whowechina/groove_pico/README.md

# Groove Pico - Groove Coaster Style Mini Controller
[点这里可以切换到中文版](README_CN.md)

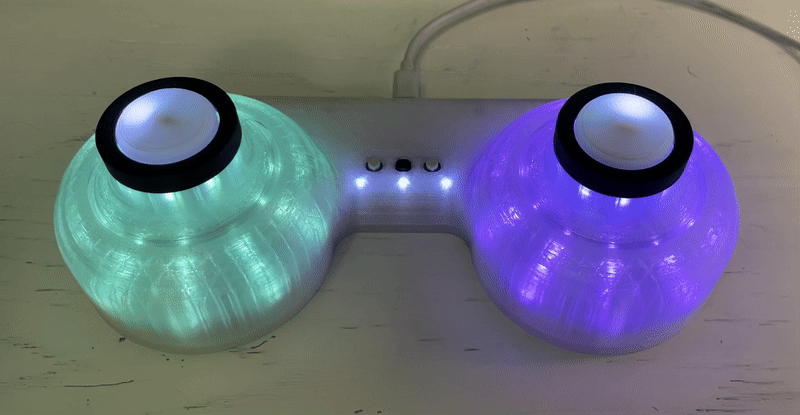
[picture p1: doc/main.gif]


Features:
* It's small but closely replicates the feel of the arcade controller.
* Works as a Nintendo Switch controller.
* Stereo haptic feedback.
* Command line for configurations.
* All source files open.

Thanks to many respectful guys/companies who made their tools or materials free or open source (KiCad, OnShape, InkScape, Raspberry things).

Special thanks to community developers that inspired me and helped me: CrazyRedMachine (https://github.com/CrazyRedMachine), asesidaa (https://github.com/asesidaa).

And also:
* RP_Silicon_KiCad: https://github.com/HeadBoffin/RP_Silicon_KiCad
* Type-C: https://github.com/ai03-2725/Type-C.pretty

## My Other Projects
You can check out my other cool projects.

             

* Popn Pico: https://github.com/whowechina/popn_pico
* IIDX Pico: https://github.com/whowechina/iidx_pico
* IIDX Teeny: https://github.com/whowechina/iidx_teeny
* Chu Pico: https://github.com/whowechina/chu_pico
* Mai Pico: https://github.com/whowechina/mai_pico
* Diva Pico: https://github.com/whowechina/diva_pico
* AIC Pico: https://github.com/whowechina/aic_pico
* Groove Pico: https://github.com/whowechina/groove_pico
* Geki Pico: https://github.com/whowechina/geki_pico
* Musec Pico: https://github.com/whowechina/musec_pico
* Ju Pico: https://github.com/whowechina/ju_pico
* Bishi Pico: https://github.com/whowechina/bishi_pico
* Bishi Pico: https://github.com/whowechina/nos_pico

## **Disclaimer** ##
I made this project in my personal time with no financial benefit or sponsorship. I will continue to improve the project. I have done my best to ensure that everything is accurate and functional, there's always a chance that mistakes may occur. I cannot be held responsible for any loss of your time or money that may result from using this open source project. Thank you for your understanding.

## About the License
It's CC-NC. So DIY for yourself and for your friend, don't make money from it. And plagiarism that doesn’t even dare to mention the original author is not acceptable. Plase note that pooling orders and group buying for raw materials is acceptable. Selling off any leftover components without profit is also acceptable.

If you're interested in buying from me, or for commercial use, please contact me (Discord, QQ group, Wechat group or leave your contact in issue section).

## My Discord Invitation
https://discord.gg/M8f2PPQFEA

## HOW TO BUILD
### PCB
* Go JLCPCB and make order with the gerber zip file (latest `Production\PCB\groove_main_xxx.zip`), regular FR-4 board, black or white color, **1.6mm** thickness.  
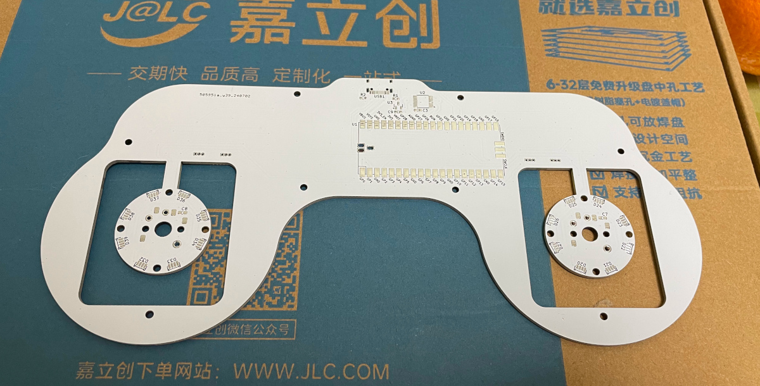
[picture p2: doc/pcb.jpg]
  
* 1x Rasberry Pico Pi Pico or pin-to-pin compatible clones (U1).  
  https://www.raspberrypi.com/products/raspberry-pi-pico
* 1x USB Type-C socket (918-418K2023S40001 or KH-TYPE-C-16P)
* 24x WS2812B-4020 side-facing RGB LEDs for the circular gimbal daughter PCBs (D20-D43).  
  https://www.lcsc.com/product-detail/Light-Emitting-Diodes-LED_Worldsemi-WS2812B-4020_C965557.html
* 19x WS2812B-3528 RGB LEDs for the main PCB (D1-D19).
* 1x 74HC4052PW, TSSOP16 package (U2).  
  https://www.lcsc.com/product-detail/Multiplexer-Demultiplexer_Nexperia-74HC4052PW_50063.html
* 2x 2N7002 SOT-23 N-Channel MOSFETs (Q1, Q2). Actually most SOT-23 package N-Channel MOSFET models will be fine.  
  https://www.nexperia.com/products/mosfets/small-signal-mosfets/2N7002.html
* 4x SH 1.25mm 3-pin connectors, both through-hole and SMD types are acceptable.  
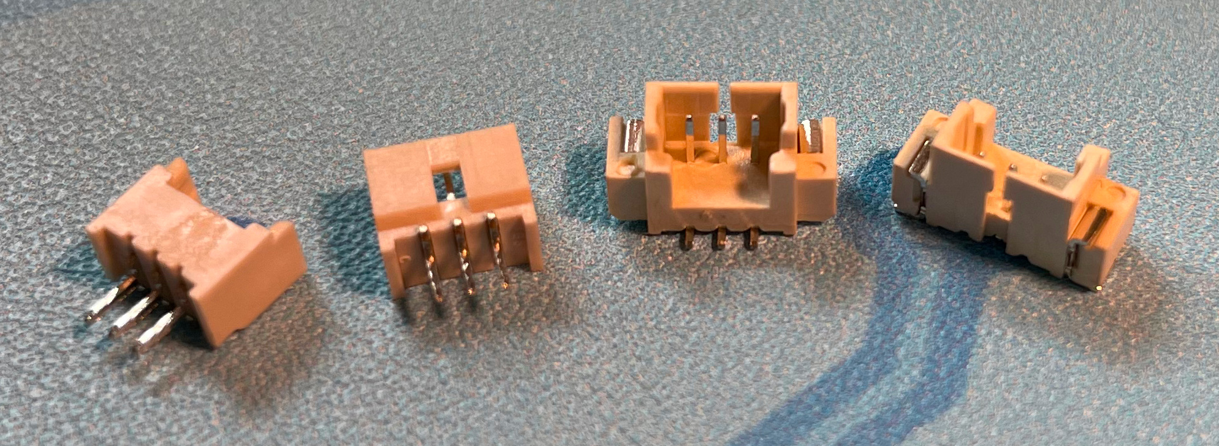
[picture p3: doc/sh125_3p.jpg]
  
* 9x 0603 0.1uF (0.1~1uF all fine) capacitors (C1 to C9), OPTIONAL but recommended.
* 2x 0603 5.1kohm resistors (R1, R2) for the USB.
* 5x 0603 10ohm resistors, (1-20ohm all work fine) (R3-R7).
* 1x LM4040A30IDBZ 3.0V shunt voltage reference (U3, SOT23-3), OPTIONAL but recommended. Model can be different, as long as it's a SOT23-3 3.0V shunt voltage reference.
* 1x 0603 100ohm resistor (R5), mandatory when U3 is present.
* 2x Kailh choc v1 switches, use light linear ones (around 35gf), such as "Red Pro".  
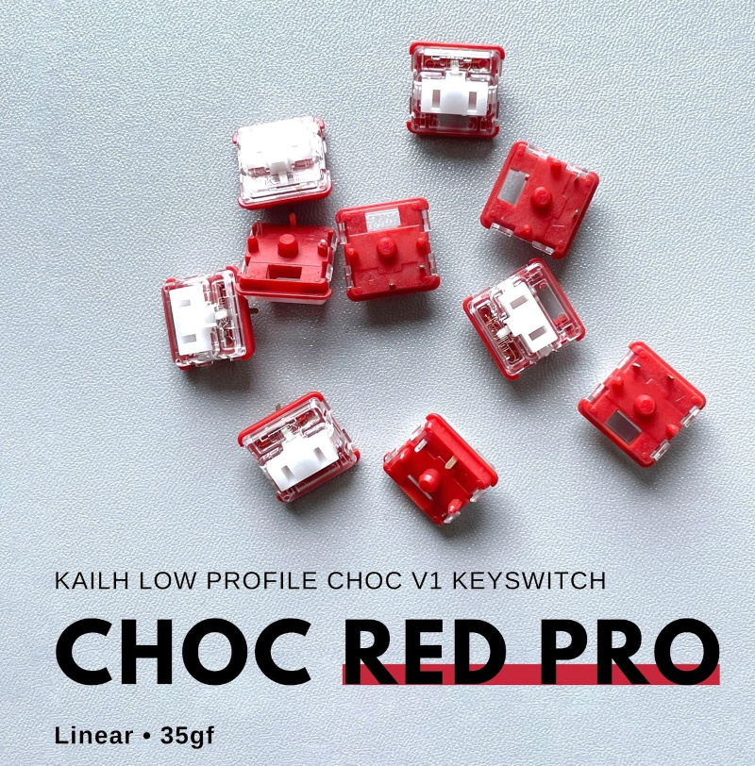
[picture p4: doc/choc_v1_red_pro.jpg]
  
* 3x ALPS SKPMAME010 or Panasonic EVQP1K05M 6mm square tactile switches, You can use either one exclusively or a combination of both.  
  https://tech.alpsalpine.com/e/products/detail/SKPMAME010/  
  https://www3.panasonic.biz/ac/e/dl/catalog/index.jsp?series_cd=3473&part_no=EVQP1K05M
* 2x BETAFPV nano gimbals (Potentiometer, Pitch/Roll Stick). You can buy them from online RC or FPV shops. Some call "Pitch/Roll stick" as directional stick which provides auto-center for both axes.  
  https://betafpv.com/products/literadio-transmitter-nano-gimbal-for-literadio-3-and-2-se?variant=39628763529350
* 2x 1027 or 1030 DC 3V flat vibration motors.  
  https://www.amazon.com/vibration-electronic-equipment-12000RPM-adhesive/dp/B08B34W24X
* 2x M3 hex nuts.
* This is how it looks after soldering. Please note that the two circular daughter PCBs are fully wired, so you can test them before cutting them off.  
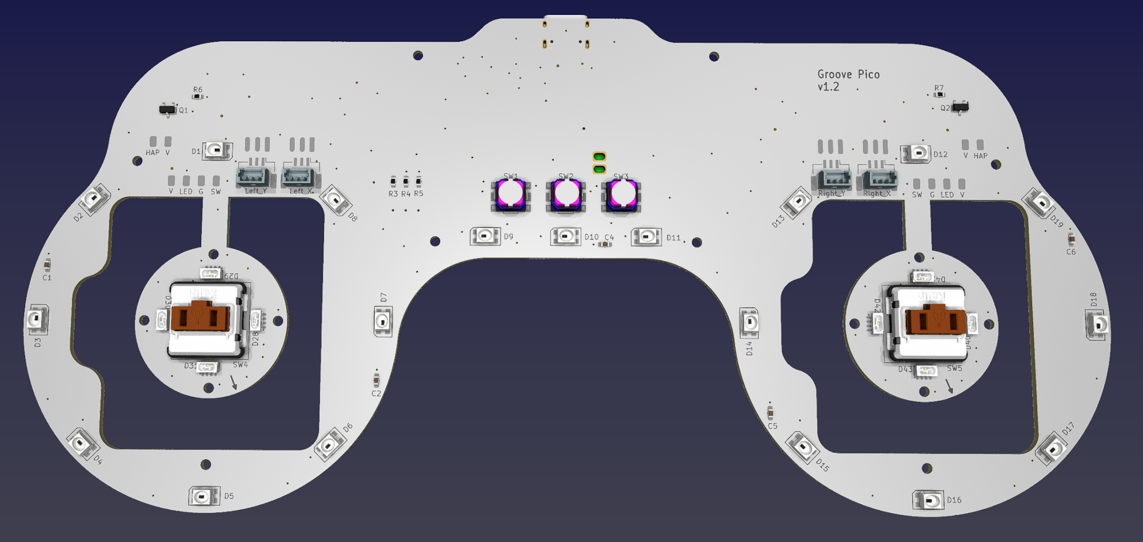
[picture p5: doc/pcb_solder_1.png]
    
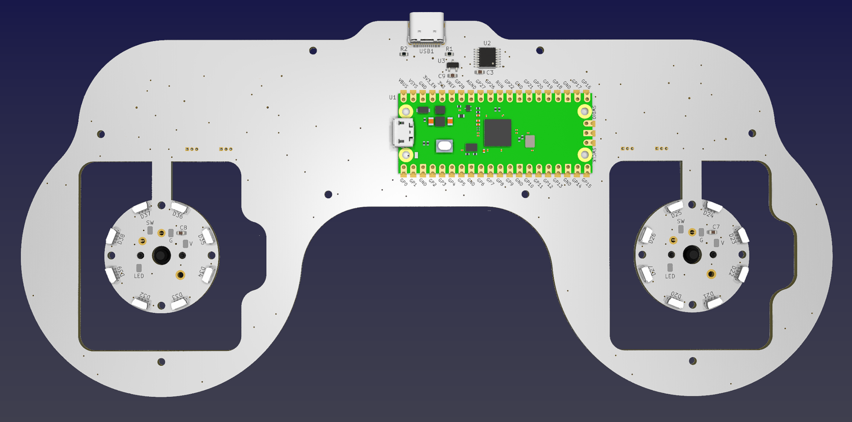
[picture p6: doc/pcb_solder_2.png]
  
* Becareful of 3 pin holes (simplifed to 2 holes in latest version) on the top side. It's a common oversight to either forget to solder them or to leave air bubbles during the process. To avoid this, solder slowly from one side of the hole, using minimal solder wire and a generous amount of flux.  
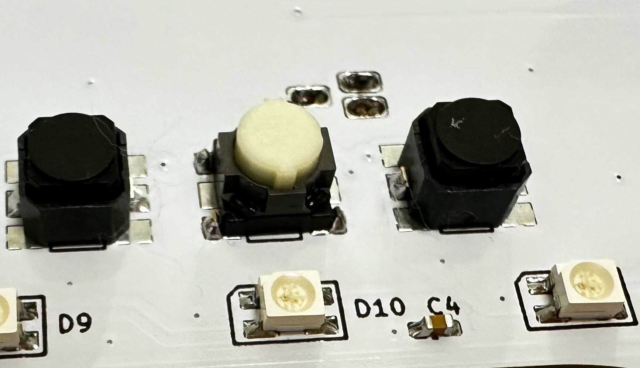
[picture p7: doc/usb_solder_txrx.jpg]
  
* After it passes the test, you need to cut the circular daughter PCBs off.  
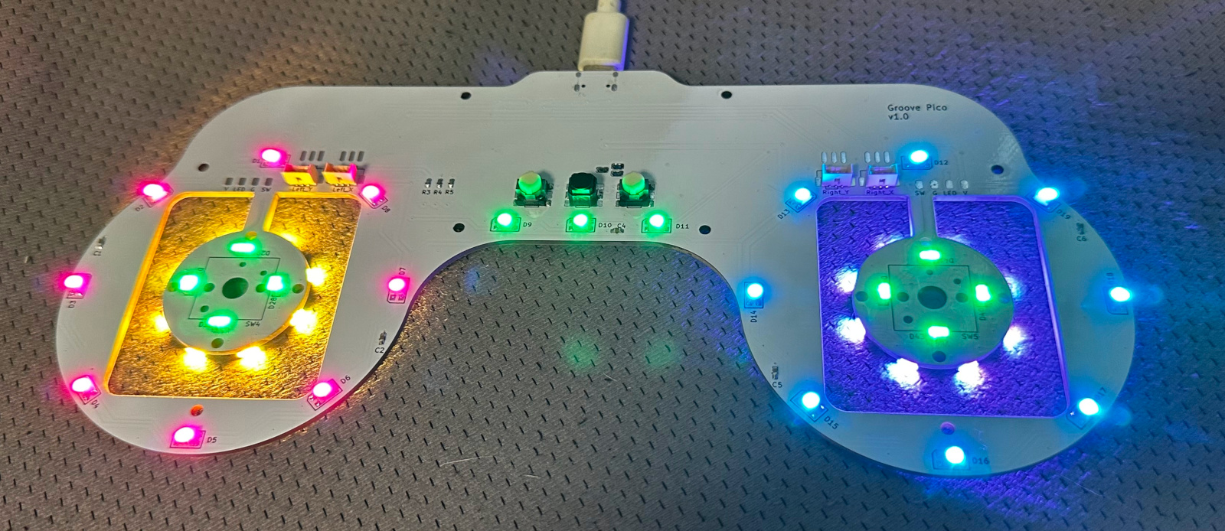
[picture p8: doc/pcb_test.jpg]
  
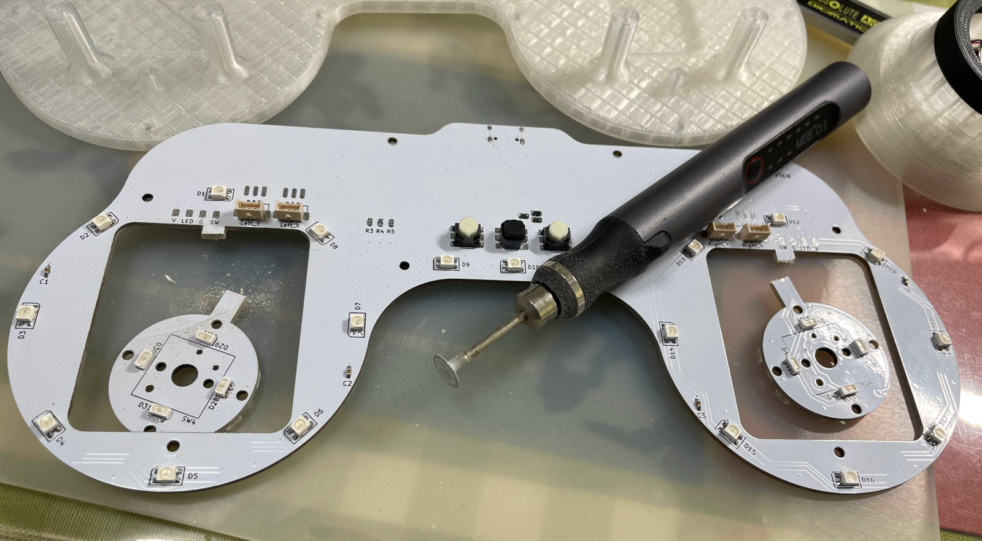
[picture p9: doc/pcb_cut_1.jpg]
  
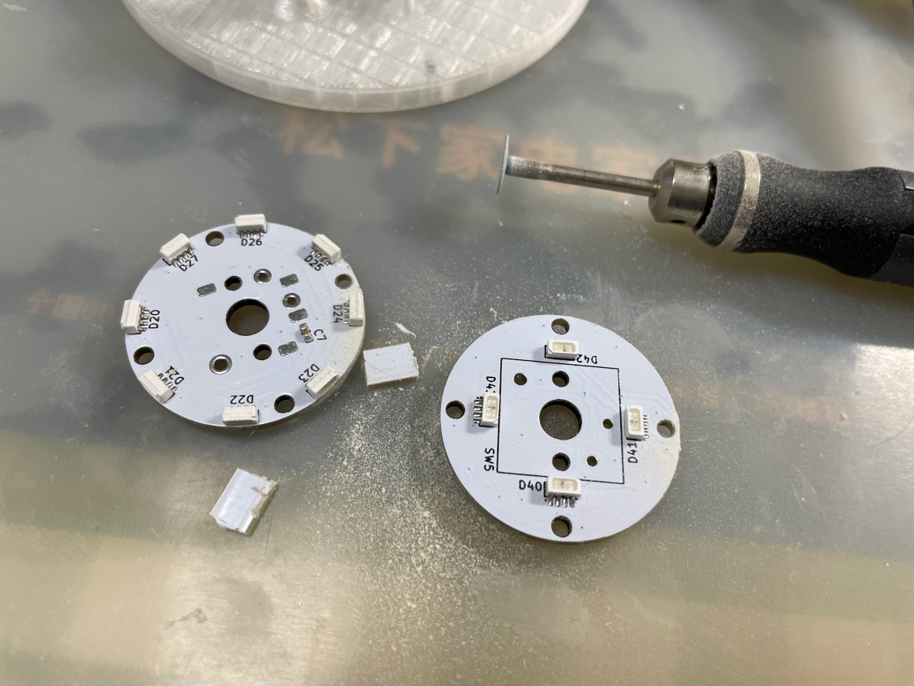
[picture p10: doc/pcb_cut_2.jpg]
  

### 3D Printing
* Printing parameters  
  * PLA, PETG, ABS are all OK.
  * Layer height: 0.2mm
  * Support: Yes, always.

* Bottom Part: `Production\3DPrint\groove_pico_bottom.stl`, semi-transparent filament.
* Top Part: `Production\3DPrint\groove_pico_top.stl`, semi-transparent filament.
* Gimbal Stick: `Production\3DPrint\groove_pico_stick.stl`, semi-transparent filament. If you have Bambu AMS system, print the upper (above 22mm) layers with black filament.
* Gimbal Bolt: `Production\3DPrint\groove_pico_bolt.stl`, white filament.
* Gimbal Tightener: `Production\3DPrint\groove_pico_tightener.stl`, white filament.
* Button cap: `Production\3DPrint\groove_pico_button_cap.stl`, white filament, print up-side down so you get nice button surface and stem. If you have Bambu AMS system, use their special support material for the interface layer.

### Nano Gimbal Modification (Optional)
* The BETAFPV Nano Gimbals are designed for RC transmitters, the original equipped springs are a little too light for Groove Pico. If you don't like the loose feel, you can change the springs by yourself.
* I measured the original springs, they're **0.3\*3\*10mm** (means 0.3mm steel wire diameter, 3mm outter diameter, 10mm free length, the first pair from the left). So if you want a heavier feel, you can use **0.35\*3\*10mm** (the second pair from the left), **0.4\*3\*10mm** (the third pair from the left), or even **0.3\*3\*8mm** (the last pair) tension springs.  
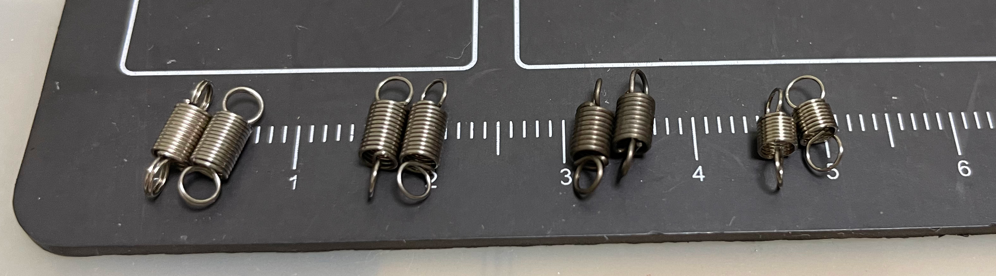
[picture p11: doc/gimbal_springs.jpg]
  
* You need to unscrew all screws to replace both X and Y axis springs. The job looks difficult but after you do it once, you'll find it's not that hard.
* You may feel the gimbal a little too bouncy, especially the X axis. You can apply some damping grease to the sliding surface to reduce the bounce (put more on X-axis sliding surface). I found Type-T03 is a good choice.  
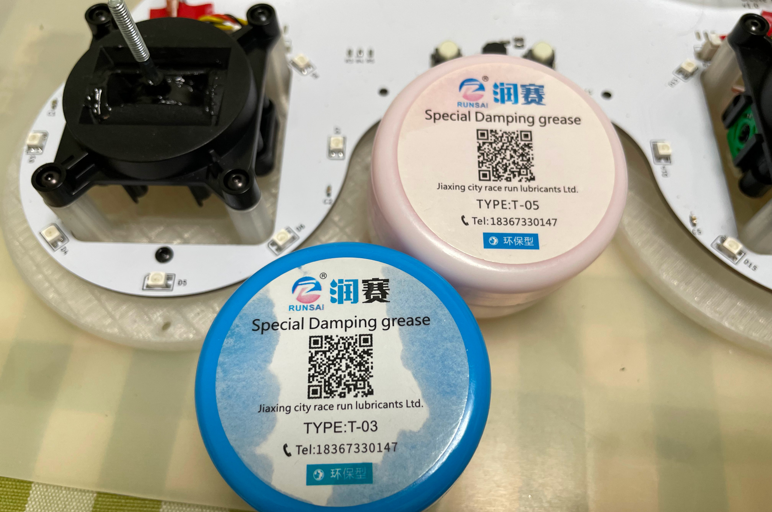
[picture p12: doc/damper_grease_1.jpg]
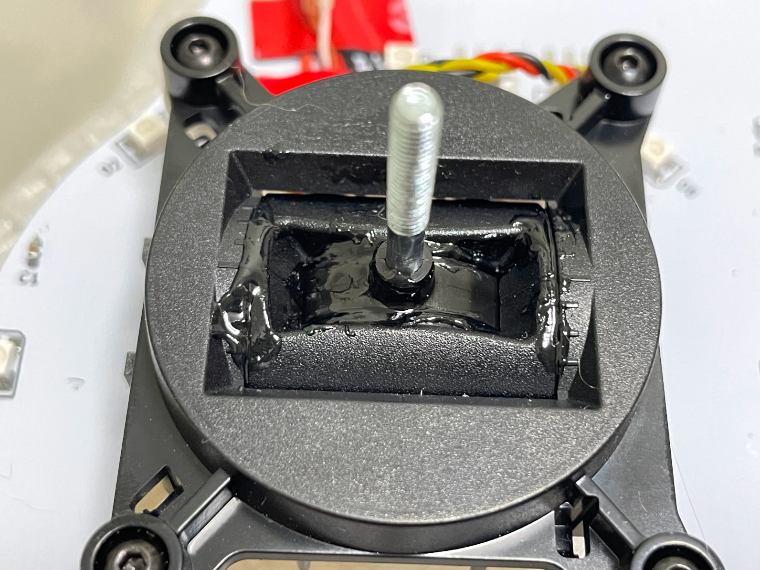
[picture p13: doc/damper_grease_2.jpg]
   

### Assembly
* Other components needed
  * 20x **M2\*4mm regular screws** to fix main PCB and daughter PCBs.
  * 20x **M2.5\*8mm regular screws** to fix the Nano Gimbals and hold bottom and top parts together.
  * 7x **10\*2** or **10\*3** (10mm diameter, 2mm or 3mm height) **self-adhesive silicone anti-slip pads** to stick to the bottom part.  
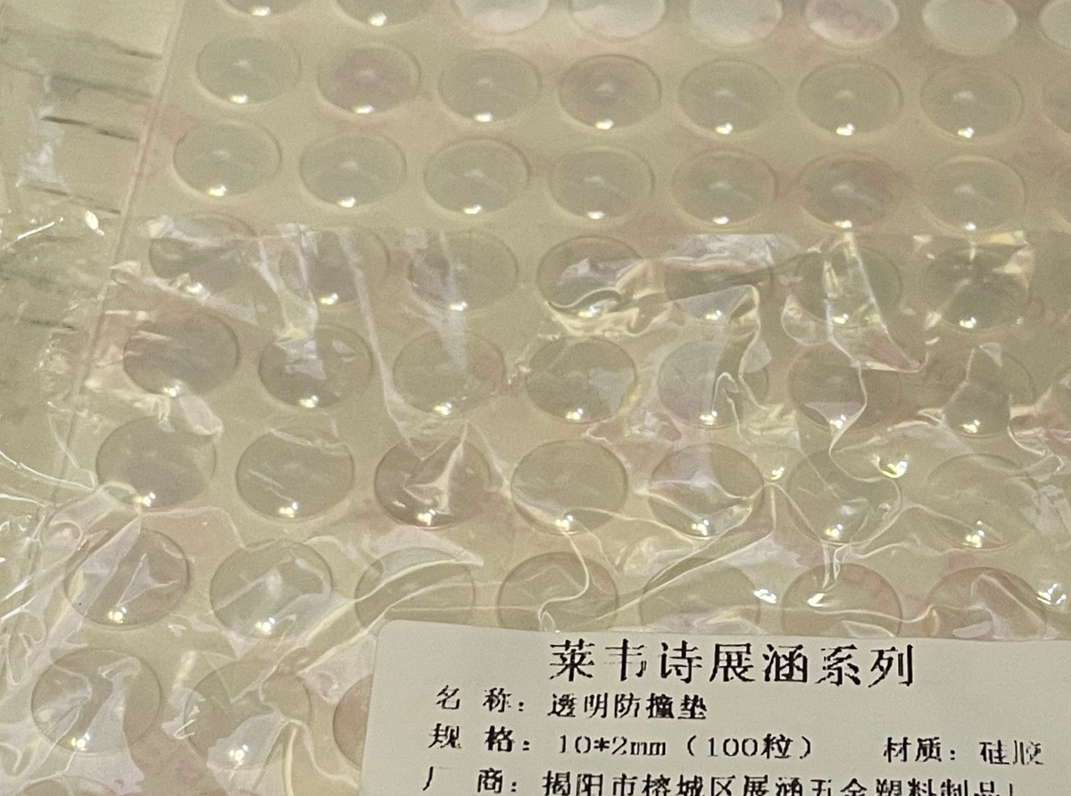
[picture p14: doc/anti_slip_pads.jpg]
    
  * 30AWG or 32AWG ultra-thin silicone (very soft) wires, better to have them in 4 colors.  
    https://www.amazon.com/StrivedayTM-Flexible-Silicone-electronic-electrics/dp/B01KQ2JNLI?th=1

* Steps
  * Solder 4 thin silicone wires to gimbal PCBs and twist them together like a braid. It would be easier if you have different colors. My mapping is red to V, black to G, blue to LED and yellow to SW.  
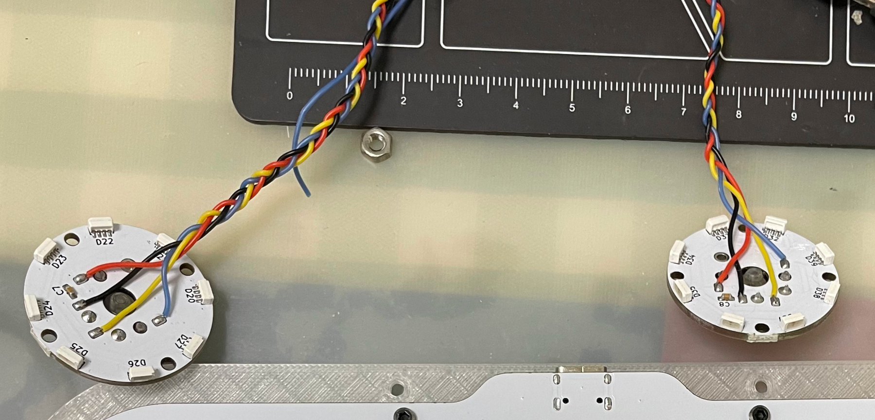
[picture p15: doc/gimbal_wires.jpg]
    
  * Install the main PCB onto the printed base, using M2 screws.
  * Attach 2 silicone wires for each motors to the main PCB, and twist them respectively.
  * Install the BETAFPV Nano Gimbals onto the printed base part using M2.5 screws. Connect the potentiometer connectors to the main PCB.  
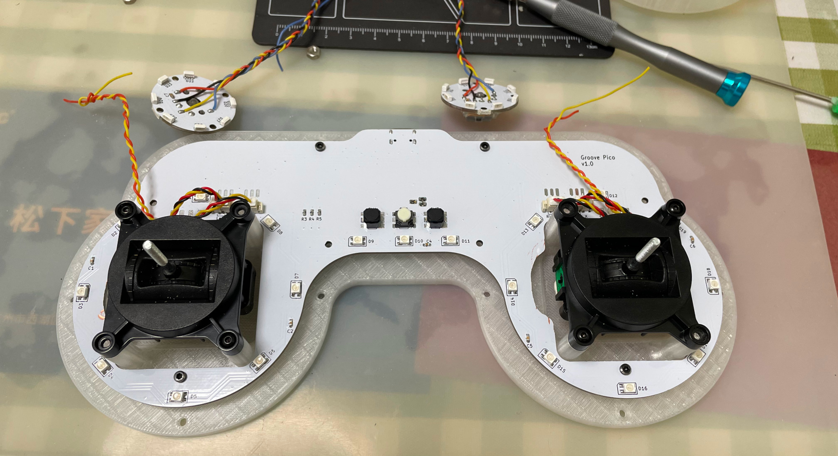
[picture p16: doc/gimbal_install.jpg]
    
  * Install the printed bolt to the shaft for both gimbals. You need to turn the bolts until there's no screw thread and then push it to the bottom.  
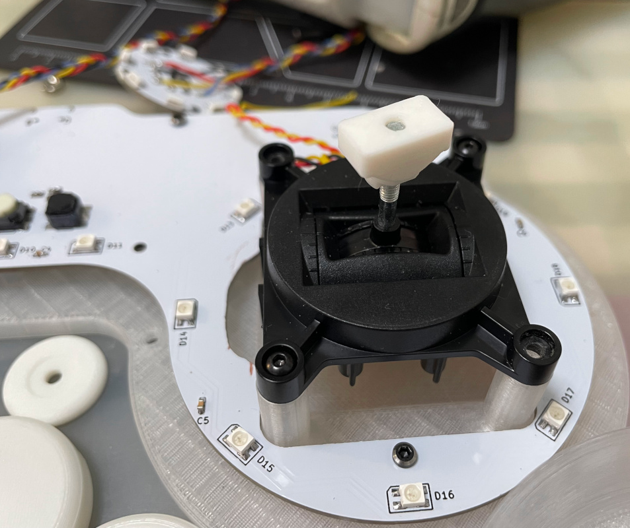
[picture p17: doc/gimbal_bolt1.jpg]
    
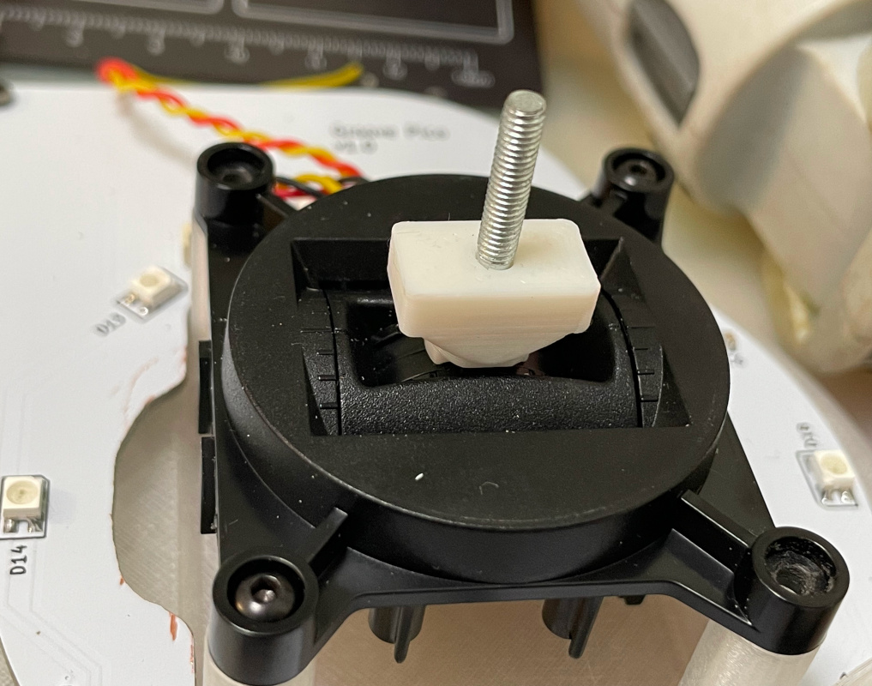
[picture p18: doc/gimbal_bolt2.jpg]
    
  * Install the printed stick onto the shaft for both gimbals. You need to use a little force to push it in.  
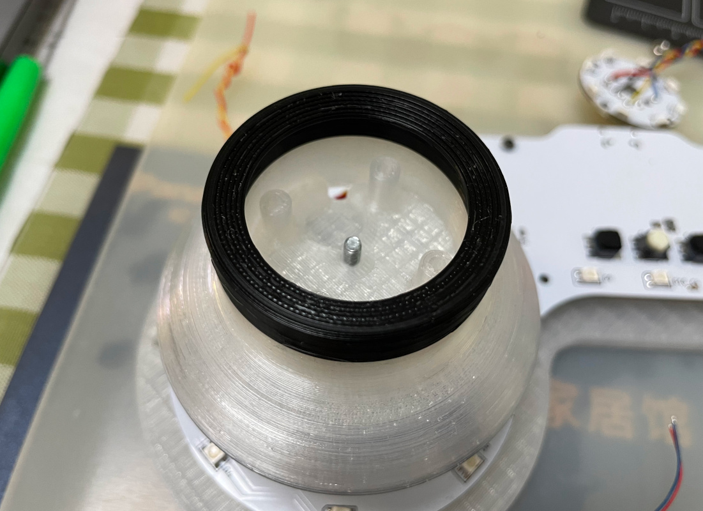
[picture p19: doc/gimbal_stick1.jpg]
    
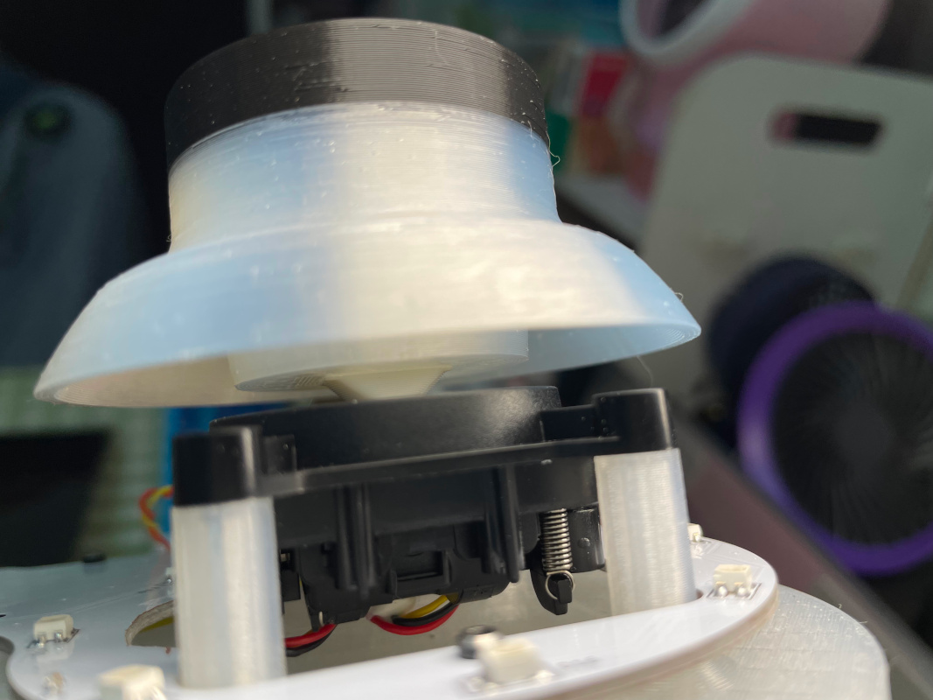
[picture p20: doc/gimbal_stick2.jpg]
    
  * Install the flat vibration motor and the gimbal PCB onto the stick and guide the wires through the hole. Finally, use the printed tightener and a hex nut to fix the stick.  
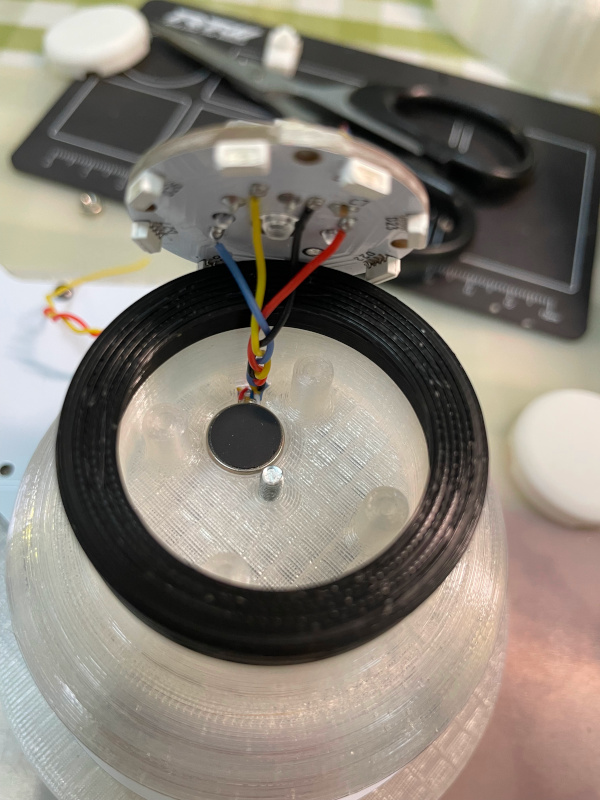
[picture p21: doc/gimbal_stick3.jpg]
    
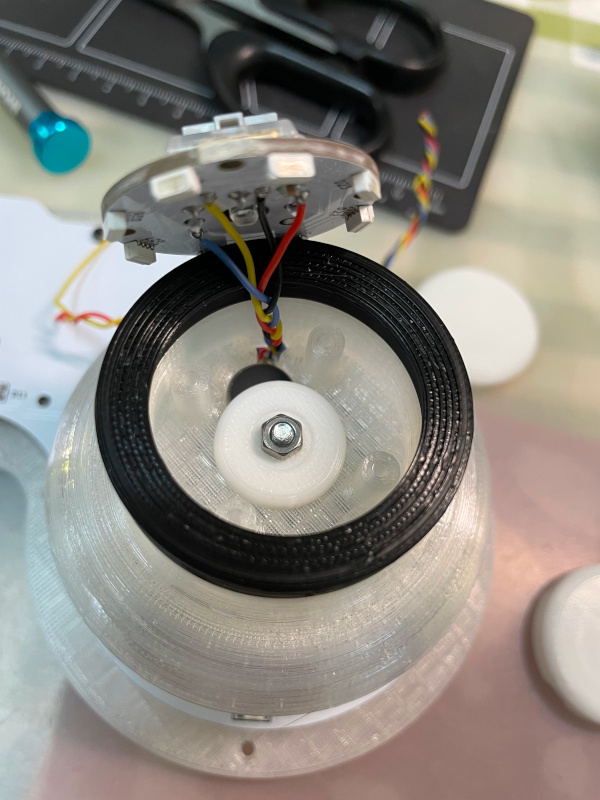
[picture p22: doc/gimbal_stick4.jpg]
    
  * Fix the gimbal PCB to the stick using M2 screws, paying special attention to the direction.  
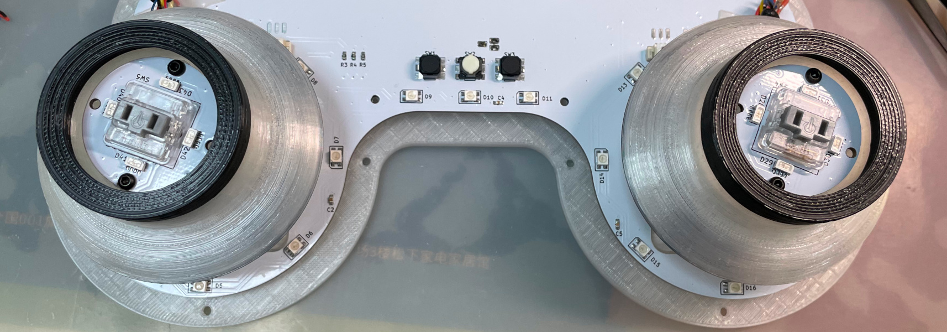
[picture p23: doc/gimbal_stick5.jpg]
    
  * Solder the wires for the gimbal PCBs and motors to the corresponding pads on the main PCB. Please reserve some extra wire length for the gimbal movement. Some duct tape can be used to fix the wires on the main PCB.  
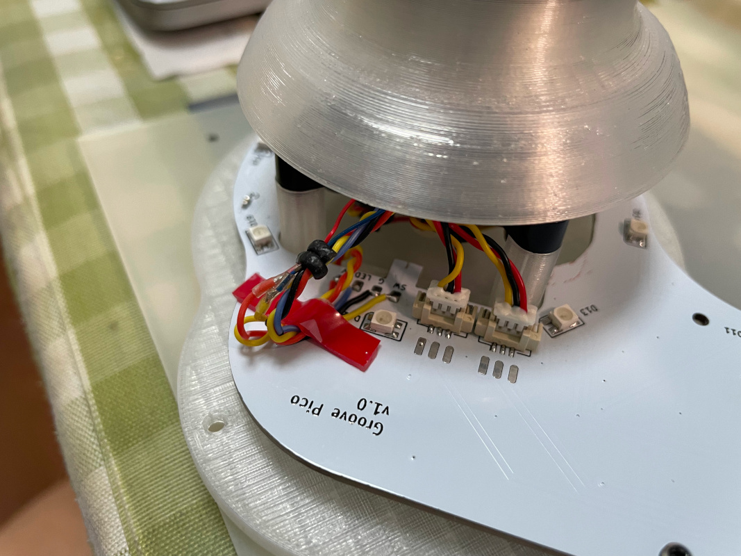
[picture p24: doc/gimbal_stick6.jpg]
    
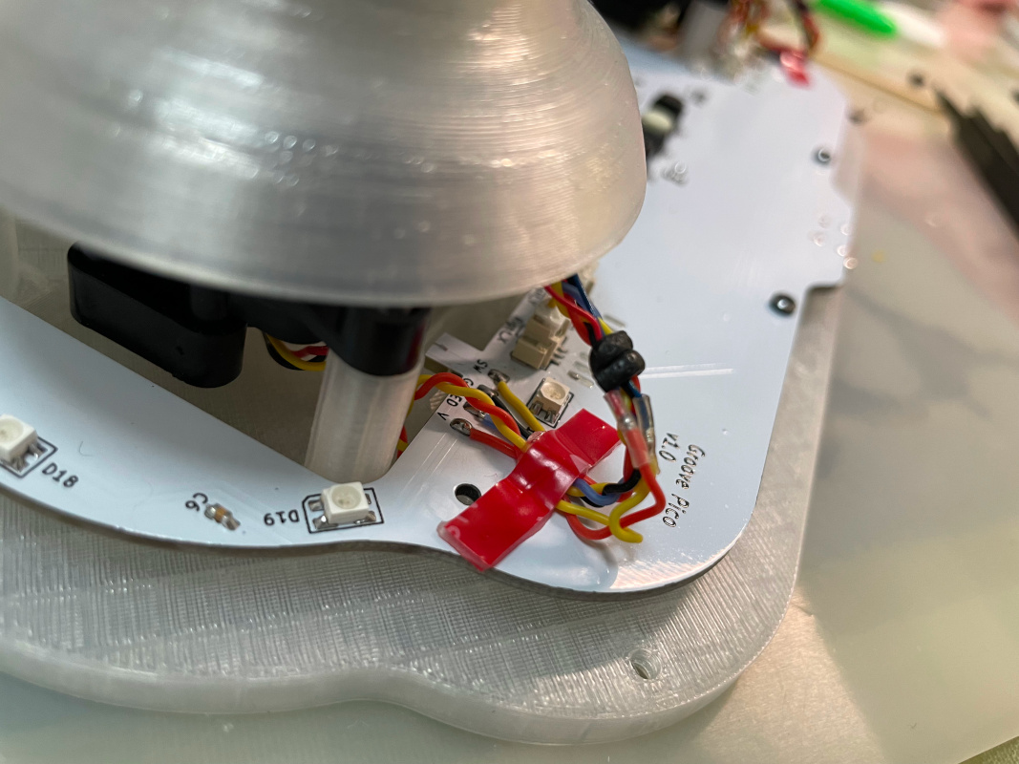
[picture p25: doc/gimbal_stick7.jpg]
    
  * Now attach the printed top part to the bottom part with M2.5 screws. And apply anti-slip pads on the bottom side.  
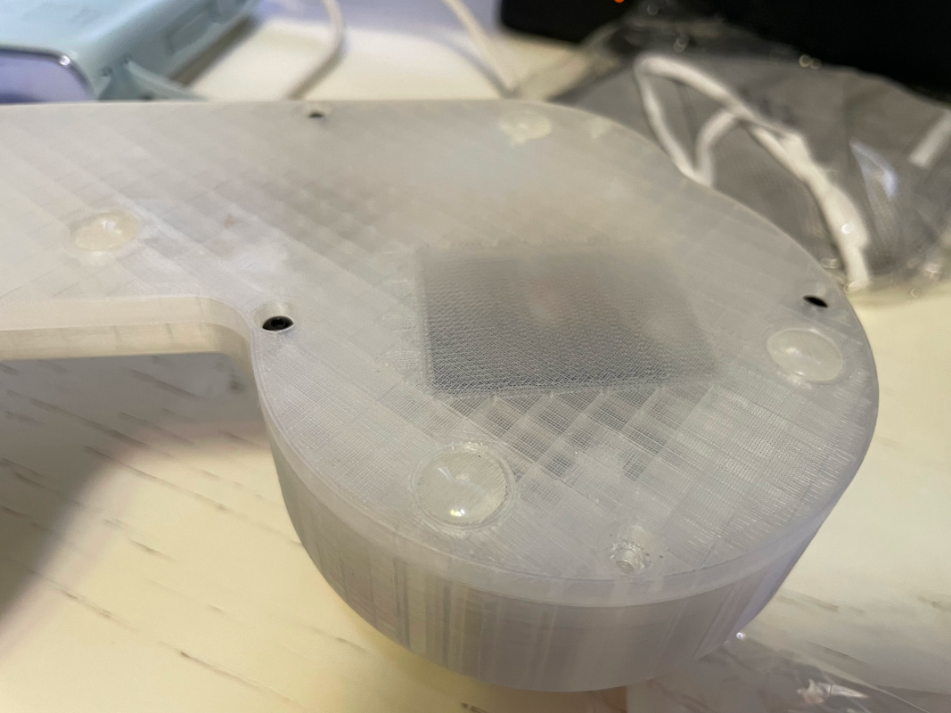
[picture p26: doc/bottom_screws.jpg]
    
  * If everything works fine, push the printed button caps onto the Choc switches and done!  
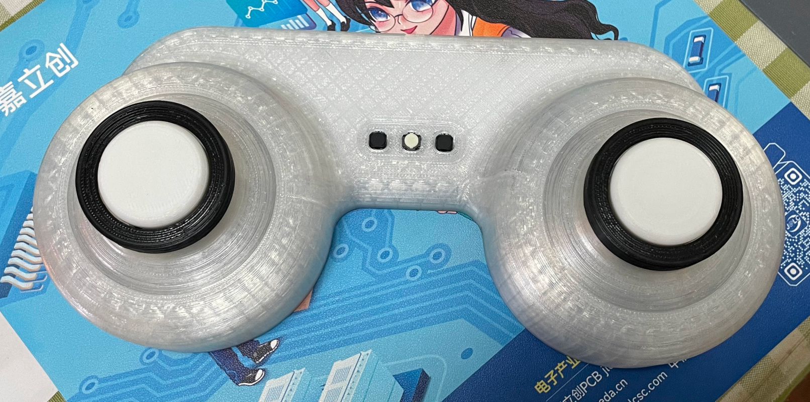
[picture p27: doc/assembly_done.jpg]
    

### Firmware
* UF2 file is in `Production\Firmware` folder.
* For the new build, hold the BOOTSEL button while connect the USB to a PC, there will be a disk named "RPI-RP2" showed up. Drag the UF2 firmware binary file into it. That's it. There's a small hole at the bottom side of the Groove Pico, it is facing right to the BOOTSEL button.
* If it's already running Groove Pico firmware, you can either use "update" in command line or hold down all 3 buttons while connecting to USB to enter update mode.
* To access the command line, you can use this Web Serial Terminal to connect to the USB serial port of the Groove Pico. (Note: "?" is for help)  
  https://googlechromelabs.github.io/serial-terminal/
* **NOTE:** You need to calibrate the gimbals by "gimbal calibrate" command after you flash the firmware.

### Usage
* Connect the Groove Pico to a Nintendo Switch or a PC, it will be recognized as a Switch controller.
* Buttons on top the left and right joysticks are `L` and `R`.
* There're three small aux buttons in the center, they are `B`, `SHIFT` and `A` respectively. If `SHIFT` is pressed:
  * The other two become `-` and `+`.
  * The joystick buttons become `Y` and `X`.
  * Left joystick works as `D-PAD`.

## CAD Source File
I'm using OnShape free subscription. It's powerful but it can't archive original designs to local, so I can only share the link here. STL/DXF/DWG files are exported from this online document.  
  https://cad.onshape.com/documents/97629d37ec7dd45f32c42fed/w/4cdf2d6010b5ce7b9283904a/e/c8e2720760e1863ce3a69460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
