whowechina/groove_pico/PCB/Main/Housing - PCB.dxf

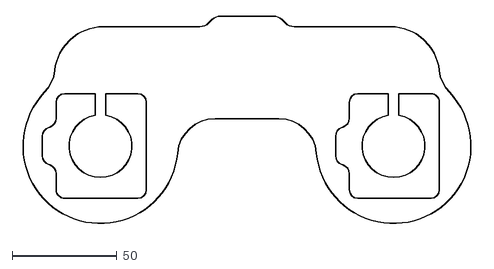
[picture p28: CAD file, 2024-07-10]
PCB/Main/Housing - PCB.dxf
220.4 x 101.6
