whowechina/groove_pico/Production/3DPrint/groove_pico_tightener.stl

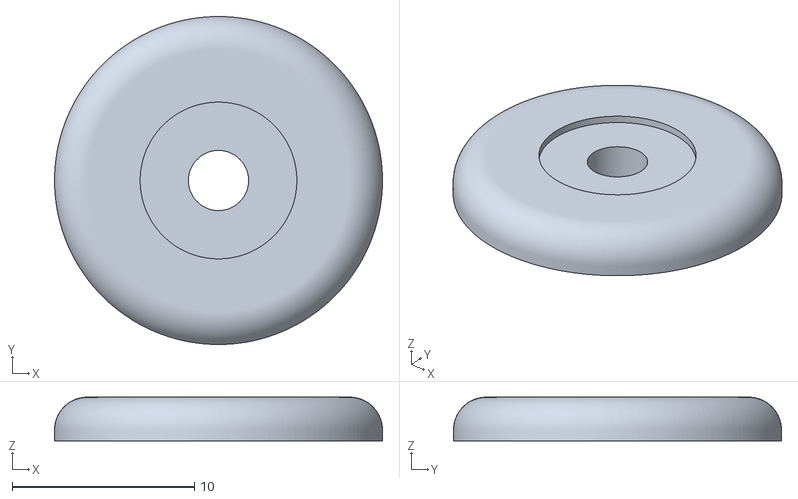
[picture p29: CAD file, 2024-07-15]
Production/3DPrint/groove_pico_tightener.stl
18.0 x 18.0 x 2.40
