whowechina/groove_pico/Production/3DPrint/groove_pico_bottom.stl

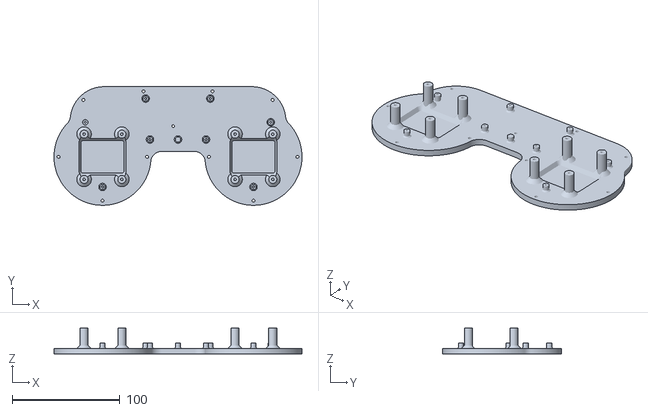
[picture p30: CAD file, 2024-07-15]
Production/3DPrint/groove_pico_bottom.stl
230.0 x 110.0 x 24.0
