whowechina/groove_pico/Production/3DPrint/groove_pico_button_cap.stl

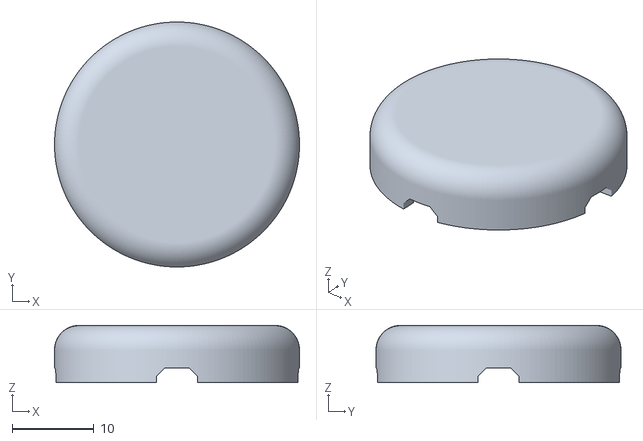
[picture p31: CAD file, 2024-07-15]
Production/3DPrint/groove_pico_button_cap.stl
30.0 x 30.0 x 7.00
