whowechina/groove_pico/Production/3DPrint/groove_pico_stick.stl

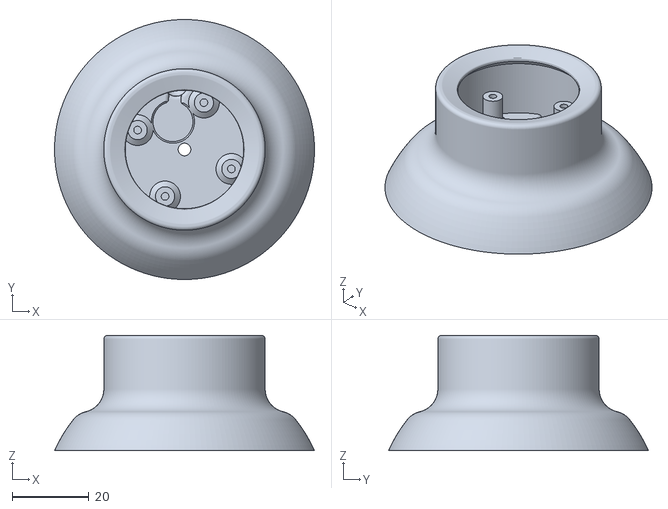
[picture p32: CAD file, 2024-07-15]
Production/3DPrint/groove_pico_stick.stl
67.6 x 67.6 x 30.0
