whowechina/groove_pico/Production/3DPrint/groove_pico_bolt.stl

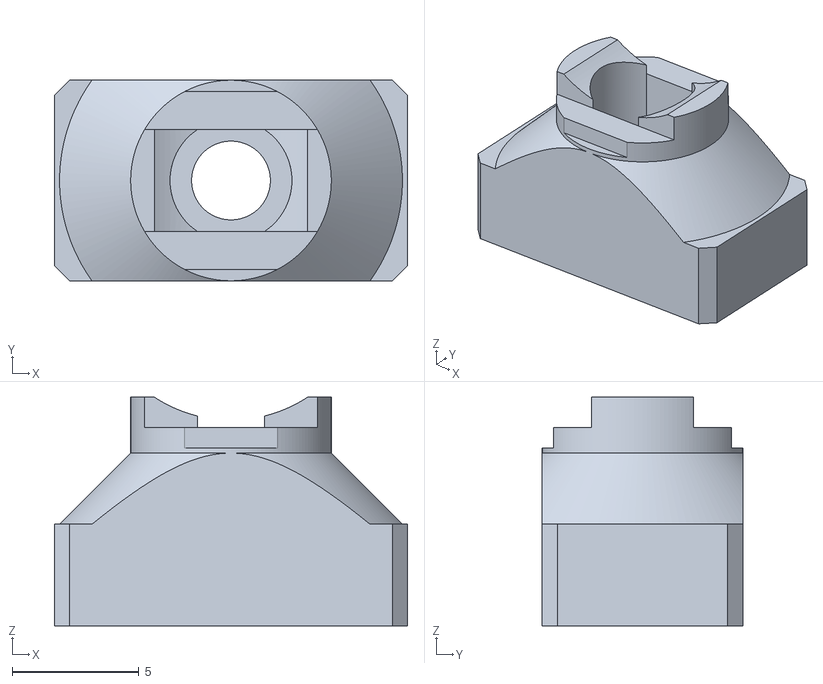
[picture p33: CAD file, 2024-07-15]
Production/3DPrint/groove_pico_bolt.stl
13.9 x 7.90 x 9.00
