whowechina/groove_pico/(threads)

Thread 1 (2025-05-02):

請考慮規劃X/Y按鍵, 以便觀看任務的功能

Aisuzuka, 2025-05-02:
為了觀看任務狀況, 時常需透過Joycon按HOME回到控制器選擇優先權控制, 將Joucon設為主後才能夠在GrooveCaoster上按X查看當前歌曲的任務狀況後, 要遊玩歌曲時則是重新設定優先權為USB
請協助規劃X/Y按鍵的功能, 例如中間按鈕按住時, 搖桿頂上變成X/Y, 免去頻繁切換裝置的不便
謝謝

whowechina, 2025-05-22:
I’ll consider that.在 2025年5月3日，02:13，Aisuzuka ***@***.***> 写道：
Aisuzuka created an issue (whowechina/groove_pico#1)
為了觀看任務狀況, 時常需透過Joycon按HOME回到控制器選擇優先權控制, 將Joucon設為主後才能夠在GrooveCaoster上按X查看當前歌曲的任務狀況後, 要遊玩歌曲時則是重新設定優先權為USB
請協助規劃X/Y按鍵的功能, 例如中間按鈕按住時, 搖桿頂上變成X/Y, 免去頻繁切換裝置的不便
謝謝

—Reply to this email directly, view it on GitHub, or unsubscribe.You are receiving this because you are subscribed to this thread.Message ID: ***@***.***>

whowechina, 2025-05-24:
I don't have a working Groove Pico in hand. Do you mind do a test for me?

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

[groove_pico_aux_test.zip](https://github.com/user-attachments/files/20421315/groove_pico_aux_test.zip)
