whowechina/groove_pico/PCB/Main/groove_main.kicad_pcb

## KiCad design PCB/Main/groove_main.kicad_pcb (2025-06-10)

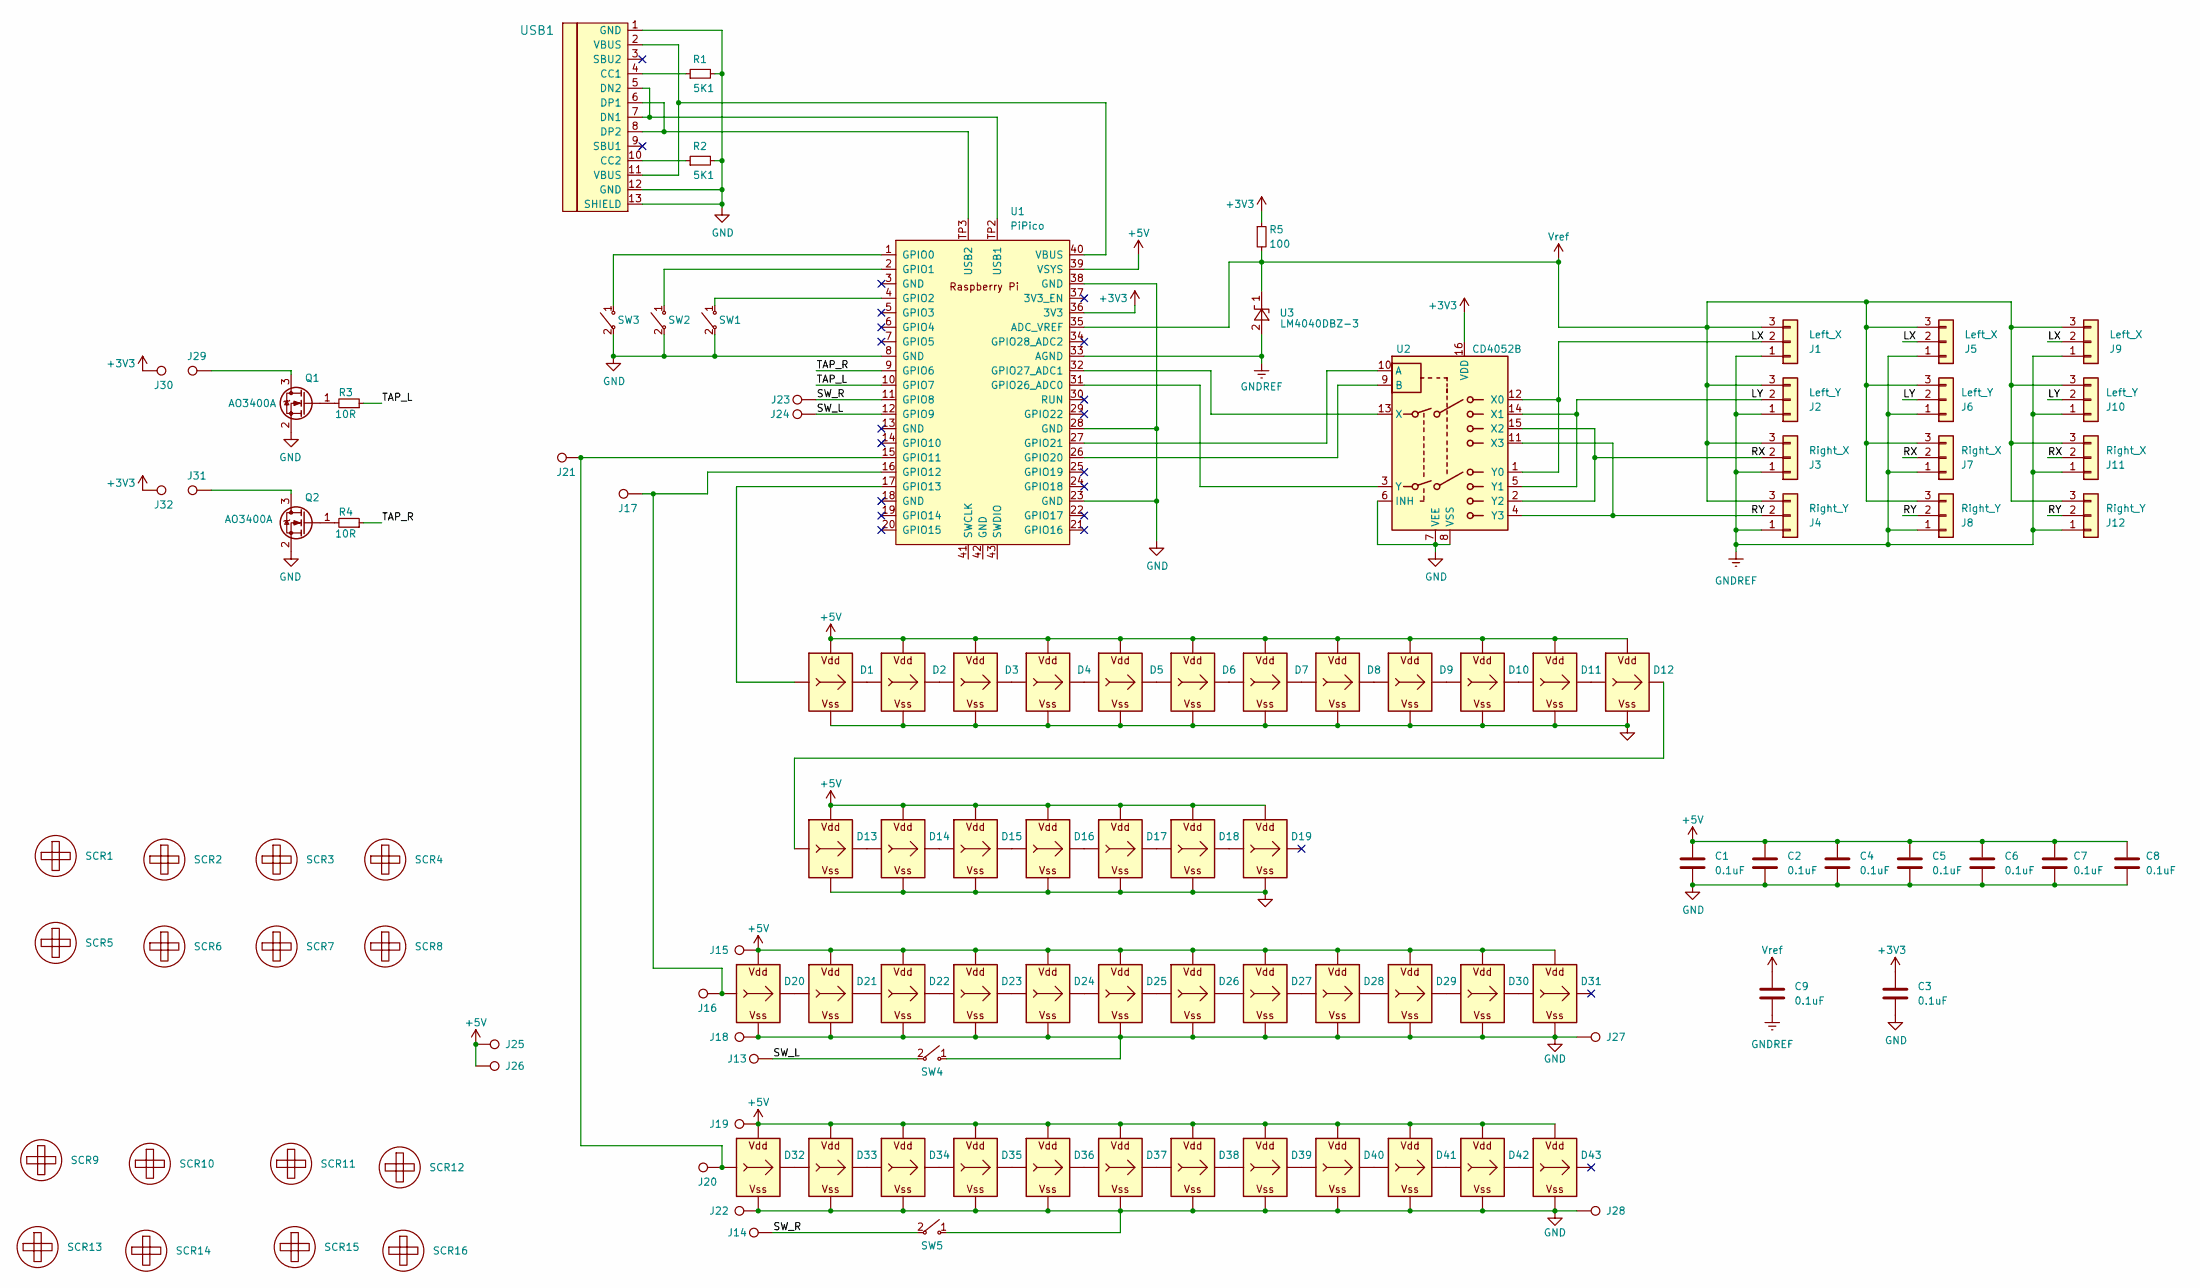
[picture p34: schematic groove_main.kicad_sch]

Parts:
C1, C2, C3, C4, C5, C6, C7, C8, C9: 0.1uF; C_0603_1608Metric_Pad1.08x0.95mm_HandSolder
D1, D2, D3, D4, D5, D6, D7, D8, D9, D10, D11, D12, D13, D14, D15, D16, D17, D18, D19: WS2812B_Unified; WS2812B-2835
D20, D21, D22, D23, D24, D25, D26, D27, D32, D33, D34, D35, D36, D37, D38, D39: WS2812B_Unified; WS2812B-4020
D28, D29, D30, D31, D40, D41, D42, D43: WS2812B_Unified; WS2812B-4020_UP
J1: Left_X; SH1.25_Thruhole_3P
J2: Left_Y; SH1.25_Thruhole_3P
J3: Right_X; SH1.25_Thruhole_3P
J4: Right_Y; SH1.25_Thruhole_3P
J5: Left_X; SH1.25mm_3P_SMD
J6: Left_Y; SH1.25mm_3P_SMD
J7: Right_X; SH1.25mm_3P_SMD
J8: Right_Y; SH1.25mm_3P_SMD
J9: Left_X; Solder_3P_S
J10: Left_Y; Solder_3P_S
J11: Right_X; Solder_3P_S
J12: Right_Y; Solder_3P_S
J13, J14, J23, J24: SW; Solder_1P_S
J15, J19, J25, J26, J30, J32: V; Solder_1P_S
J16, J17, J20, J21: LED; Solder_1P_S
J18, J22, J27, J28: G; Solder_1P_S
J29, J31: HAP; Solder_1P_S
Q1, Q2: AO3400A; SOT-23
R1, R2: 5K1; R_0603_1608Metric_Pad0.98x0.95mm_HandSolder; LCSC C23186
R3, R4: 10R; R_0603_1608Metric_Pad0.98x0.95mm_HandSolder; LCSC C22962
R5: 100; R_0603_1608Metric_Pad0.98x0.95mm_HandSolder; LCSC C23186
SCR1, SCR2, SCR3, SCR4, SCR5, SCR6, SCR7, SCR8, SCR9, SCR10, SCR11, SCR12, SCR13, SCR14, SCR15, SCR16: ScrewHole; Hole2.0
SW1, SW2, SW3: SWITCH_SPST; EVQP1K05M
SW4, SW5: SWITCH_SPST; SW_Kailh_Choc_V1V2_1.00u_LED
U1: PiPico; RPi_Pico_SMD_Pins
U2: CD4052B; TSSOP-16_4.4x5mm_P0.65mm
U3: LM4040DBZ-3; SOT-23
USB1: U262-161N-4BVC11; HRO-TYPE-C-31-M-12-Assembly; LCSC C319148

Connections:
+3V3: C3.1, J30.1, J32.1, R5.1, U1.36 (3V3), U2.16 (VDD)
+5V: C1.1, C2.1, C4.1, C5.1, C6.1, C7.1, C8.1, D1.V (VDD), D2.V (VDD), D3.V (VDD), D4.V (VDD), D5.V (VDD), D6.V (VDD), D7.V (VDD), D8.V (VDD), D9.V (VDD), D10.V (VDD), D11.V (VDD), D12.V (VDD), D13.V (VDD), D14.V (VDD), D15.V (VDD), D16.V (VDD), D17.V (VDD), D18.V (VDD), D19.V (VDD), D20.V (VDD), D21.V (VDD), D22.V (VDD), D23.V (VDD), D24.V (VDD), D25.V (VDD), D26.V (VDD), D27.V (VDD), D28.V (VDD), D29.V (VDD), D30.V (VDD), D31.V (VDD), D32.V (VDD), D33.V (VDD), D34.V (VDD), D35.V (VDD), D36.V (VDD), D37.V (VDD), D38.V (VDD), D39.V (VDD), D40.V (VDD), D41.V (VDD), D42.V (VDD), D43.V (VDD), J15.1, J19.1, J25.1, J26.1, U1.39 (VSYS)
/LX: J1.2, J5.2, J9.2, U2.1 (Y0), U2.12 (X0)
/LY: J2.2, J6.2, J10.2, U2.5 (Y1), U2.14 (X1)
/RX: J3.2, J7.2, J11.2, U2.2 (Y2), U2.15 (X2)
/RY: J4.2, J8.2, J12.2, U2.4 (Y3), U2.11 (X3)
/SW_L: J13.1, J24.1, SW4.2 ("~"), U1.12 (GPIO9)
/SW_R: J14.1, J23.1, SW5.2 ("~"), U1.11 (GPIO8)
/TAP_L: R3.1, U1.10 (GPIO7)
/TAP_R: R4.1, U1.9 (GPIO6)
GND: C1.2, C2.2, C3.2, C4.2, C5.2, C6.2, C7.2, C8.2, D1.G (VSS), D2.G (VSS), D3.G (VSS), D4.G (VSS), D5.G (VSS), D6.G (VSS), D7.G (VSS), D8.G (VSS), D9.G (VSS), D10.G (VSS), D11.G (VSS), D12.G (VSS), D13.G (VSS), D14.G (VSS), D15.G (VSS), D16.G (VSS), D17.G (VSS), D18.G (VSS), D19.G (VSS), D20.G (VSS), D21.G (VSS), D22.G (VSS), D23.G (VSS), D24.G (VSS), D25.G (VSS), D26.G (VSS), D27.G (VSS), D28.G (VSS), D29.G (VSS), D30.G (VSS), D31.G (VSS), D32.G (VSS), D33.G (VSS), D34.G (VSS), D35.G (VSS), D36.G (VSS), D37.G (VSS), D38.G (VSS), D39.G (VSS), D40.G (VSS), D41.G (VSS), D42.G (VSS), D43.G (VSS), J18.1, J22.1, J27.1, J28.1, Q1.2 (S), Q2.2 (S), R1.2, R2.2, SW1.2 ("~"), SW2.2 ("~"), SW3.2 ("~"), SW4.1 ("~"), SW5.1 ("~"), U1.8 (GND), U1.23 (GND), U1.28 (GND), U1.38 (GND), U2.6 (INH), U2.7 (VEE), U2.8 (VSS), USB1.1 (GND), USB1.12 (GND), USB1.13 (SHIELD)
GNDREF: C9.2, J1.1, J2.1, J3.1, J4.1, J5.1, J6.1, J7.1, J8.1, J9.1, J10.1, J11.1, J12.1, U1.33 (AGND), U3.2 (A)
unnamed: D1.I (In), U1.17 (GPIO13)
unnamed: D1.O (Out), D2.I (In)
unnamed: D2.O (Out), D3.I (In)
unnamed: D3.O (Out), D4.I (In)
unnamed: D4.O (Out), D5.I (In)
unnamed: D5.O (Out), D6.I (In)
unnamed: D6.O (Out), D7.I (In)
unnamed: D7.O (Out), D8.I (In)
unnamed: D8.O (Out), D9.I (In)
unnamed: D9.O (Out), D10.I (In)
unnamed: D10.O (Out), D11.I (In)
unnamed: D11.O (Out), D12.I (In)
unnamed: D12.O (Out), D13.I (In)
unnamed: D13.O (Out), D14.I (In)
unnamed: D14.O (Out), D15.I (In)
unnamed: D15.O (Out), D16.I (In)
unnamed: D16.O (Out), D17.I (In)
unnamed: D17.O (Out), D18.I (In)
unnamed: D18.O (Out), D19.I (In)
unnamed: D20.I (In), J16.1, J17.1, U1.16 (GPIO12)
unnamed: D20.O (Out), D21.I (In)
unnamed: D21.O (Out), D22.I (In)
unnamed: D22.O (Out), D23.I (In)
unnamed: D23.O (Out), D24.I (In)
unnamed: D24.O (Out), D25.I (In)
unnamed: D25.O (Out), D26.I (In)
unnamed: D26.O (Out), D27.I (In)
unnamed: D27.O (Out), D28.I (In)
unnamed: D28.O (Out), D29.I (In)
unnamed: D29.O (Out), D30.I (In)
unnamed: D30.O (Out), D31.I (In)
unnamed: D32.I (In), J20.1, J21.1, U1.15 (GPIO11)
unnamed: D32.O (Out), D33.I (In)
unnamed: D33.O (Out), D34.I (In)
unnamed: D34.O (Out), D35.I (In)
unnamed: D35.O (Out), D36.I (In)
unnamed: D36.O (Out), D37.I (In)
unnamed: D37.O (Out), D38.I (In)
unnamed: D38.O (Out), D39.I (In)
unnamed: D39.O (Out), D40.I (In)
unnamed: D40.O (Out), D41.I (In)
unnamed: D41.O (Out), D42.I (In)
unnamed: D42.O (Out), D43.I (In)
unnamed: J29.1, Q1.3 (D)
unnamed: Q1.1 (G), R3.2
unnamed: J31.1, Q2.3 (D)
unnamed: Q2.1 (G), R4.2
unnamed: SW3.1 ("~"), U1.1 (GPIO0)
unnamed: SW2.1 ("~"), U1.2 (GPIO1)
unnamed: SW1.1 ("~"), U1.4 (GPIO2)
unnamed: U1.26 (GPIO20), U2.9 (B)
unnamed: U1.27 (GPIO21), U2.10 (A)
unnamed: U1.31 (GPIO26_ADC0), U2.3 (Y)
unnamed: U1.32 (GPIO27_ADC1), U2.13 (X)
unnamed: U1.TP2 (USB1), USB1.5 (DN2), USB1.7 (DN1)
unnamed: U1.TP3 (USB2), USB1.6 (DP1), USB1.8 (DP2)
unnamed: U1.40 (VBUS), USB1.2 (VBUS), USB1.11 (VBUS)
unnamed: R1.1, USB1.4 (CC1)
unnamed: R2.1, USB1.10 (CC2)
Vref: C9.1, J1.3, J2.3, J3.3, J4.3, J5.3, J6.3, J7.3, J8.3, J9.3, J10.3, J11.3, J12.3, R5.2, U1.35 (ADC_VREF), U3.1 (K)

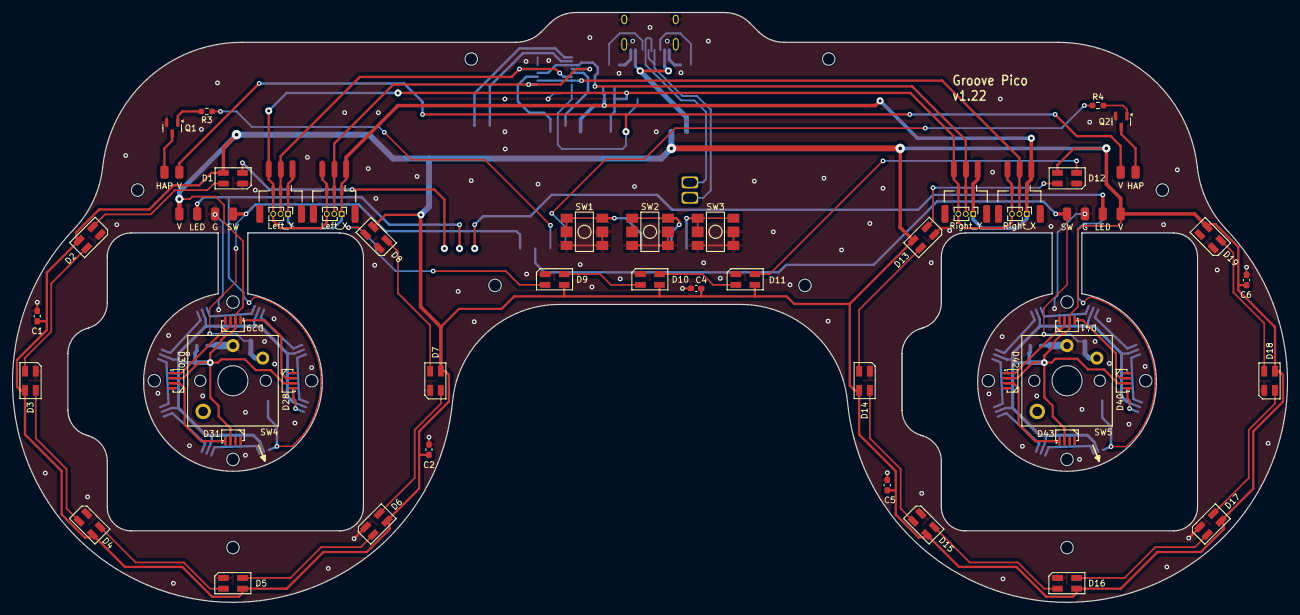
[picture p35: board groove_main.kicad_pcb from above]

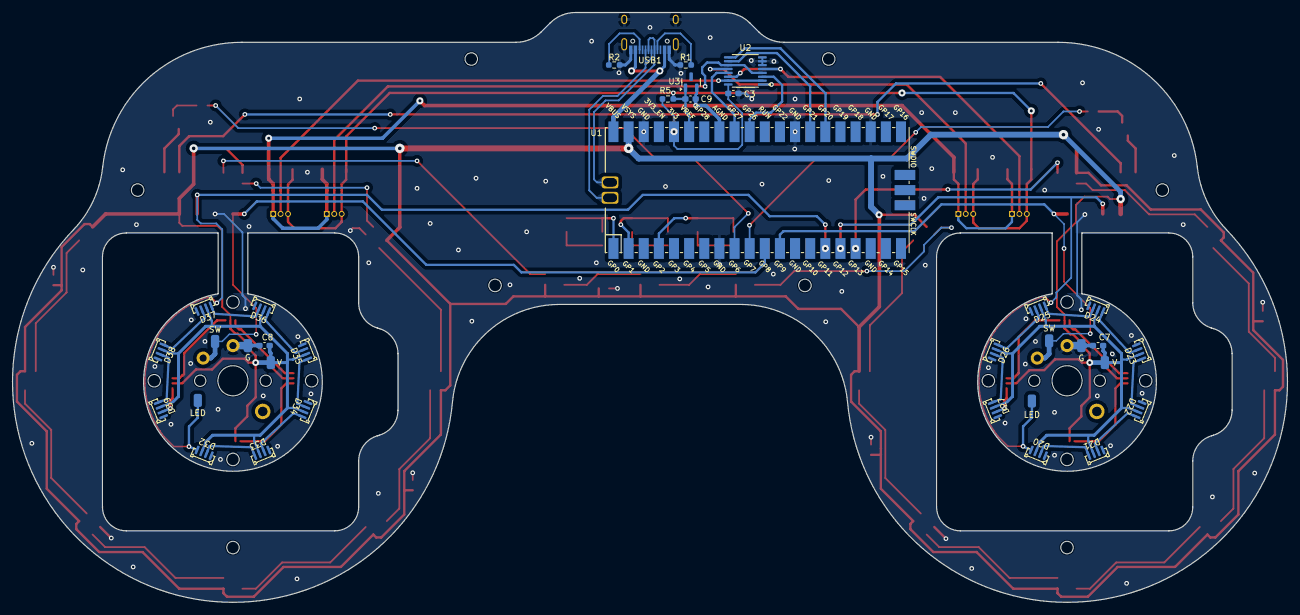
[picture p36: board groove_main.kicad_pcb from below]

Board: 2 copper layers, 214.0 x 99.0 mm, 116 parts (35 on the bottom side), 72 nets.
