whowechina/groove_pico/firmware/src/gimbal.h

/*
 * Left and Right Gimbal Inputs
 * WHowe <github.com/whowechina>
 */

#ifndef GIMBAL_H
#define GIMBAL_H

#include <stdint.h>
#include <stdbool.h>

void gimbal_init();

typedef enum {
    GIMBAL_LEFT_X = 0,
    GIMBAL_LEFT_Y,
    GIMBAL_RIGHT_X,
    GIMBAL_RIGHT_Y,
} gimbal_axis_t;

uint16_t gimbal_read(gimbal_axis_t axis);
uint16_t gimbal_raw(gimbal_axis_t axis);

/* -1 for no angle, [0..7] for 8 gimbal directions */
int gimbal_get_dir(int gimbal);
int gimbal_get_amp(int gimbal);
#endif
