whowechina/groove_pico/(commit log)

2024-06-26 Gimbal PCB v1.0
    [groove_gimbal.kicad_pcb, groove_gimbal.kicad_sch]
2024-06-30 Main PCB in progress (20%)
    [groove_main.kicad_pcb, groove_main.kicad_sch]
2024-06-30 Main PCB progress 50%
    [Housing - PCB.dxf, groove_main.kicad_pcb, groove_main.kicad_sch]
2024-06-30 Main PCB progress 70%
    [Housing - PCB.dxf, groove_main.kicad_pcb, groove_main.kicad_sch]
2024-07-01 Main PCB progress 85%
    [groove_main.kicad_pcb, groove_main.kicad_sch]
2024-07-02 Main PCB v1.0
    [groove_main.kicad_pcb, groove_main.kicad_sch]
2024-07-05 Basic ws2812 based light driver
2024-07-07 Firmware roughly working on a Switch
2024-07-08 Gimbal calibration
2024-07-09 Add slots in PCB for Hall gimbals
    [Housing - PCB.dxf, groove_main.kicad_pcb, groove_main.kicad_sch]
2024-07-10 Main PCB v1.1
    [Housing - PCB.dxf, groove_main.kicad_pcb]
2024-07-12 Shorten gimbal calibration time
    [commands.c]
2024-07-13 Steering light is there.
2024-07-13 Optimize smd jst connector footprint
    [groove_main.kicad_pcb]
2024-07-14 PCB v1.2 (easier USB soldering holes)
    [groove_main.kicad_pcb, groove_main.kicad_sch]
2024-07-14 Remove gimbal PCB
    [groove_gimbal.kicad_pcb, groove_gimbal.kicad_sch]
2024-07-15 Upload STL files
    [groove_pico_bolt.stl, groove_pico_bottom.stl, groove_pico_button_cap.stl, groove_pico_stick.stl, groove_pico_tightener.stl]
2024-07-15 Correcting gimbal axis direction
    [config.c, gimbal.c]
2024-07-16 Nano gimbal tension spring mod
2024-11-23 Fix a color assignment bug
    [commands.c]
2024-11-24 Explaining button assignment
2024-12-01 Improve screw holes
2024-12-07 PCB v1.21 (easier soldering)
    [groove_main.kicad_pcb, groove_main.kicad_sch]
2025-06-10 Improve voltage reference design
    [groove_main.kicad_pcb, groove_main.kicad_sch]
2025-06-11 More switch keys when "ALT" is pressed
